yahyaEkin/EVSE_Charge_Controller/Schematic_EVSE_2024-11-07.pdf

IO0 25 IO4 26 IO16 27 IO17 28 IO5 29 IO18 30 IO19 31 NC 32 IO21 33 RXD0 34 TXD0 35 IO22 36 IO23 37 GND 38 P_GND 39

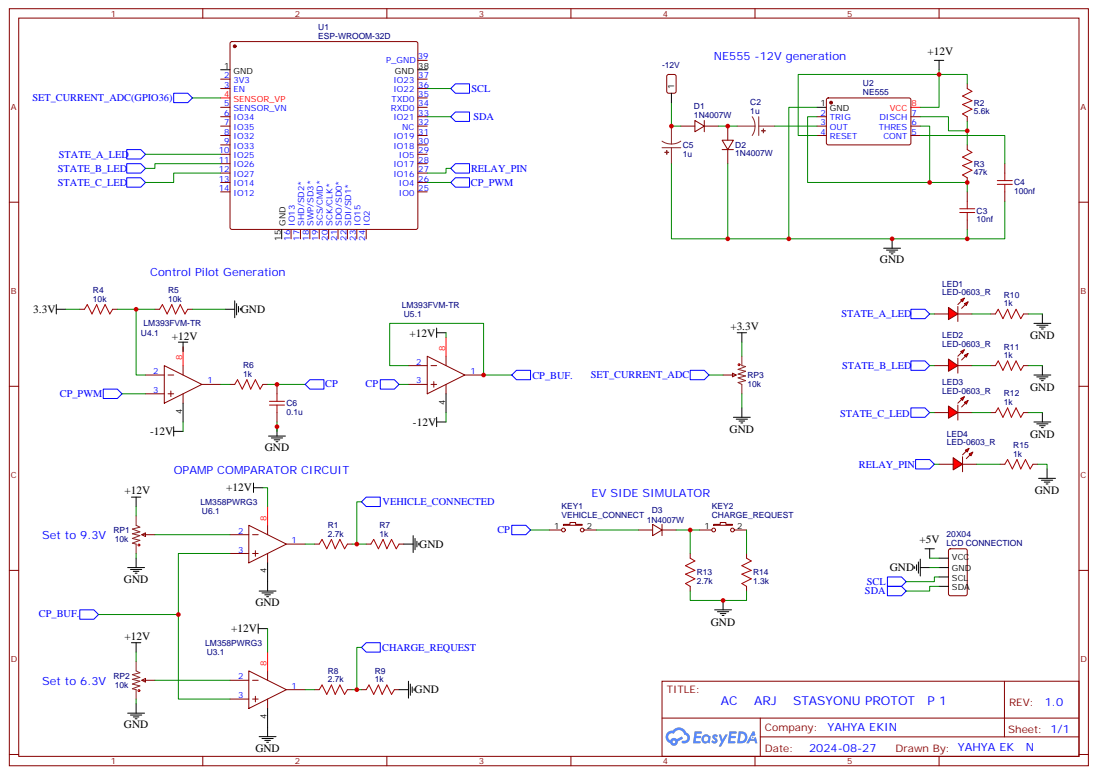
[picture p12: page 1]
